boda-akos/STM32_Voltmeter_Data-Logger_Curve-Tracer_Continuity-Tester/DSCF2569 (Nagy).JPG

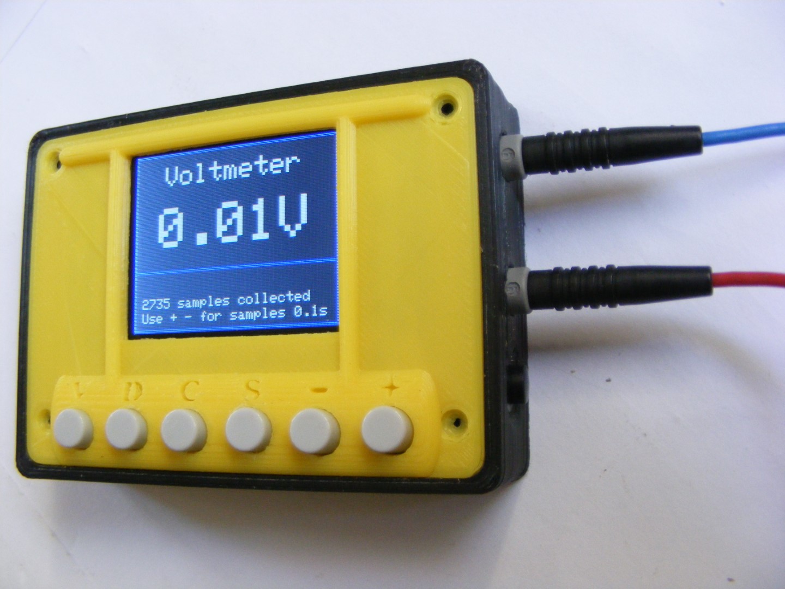
DSCF2569 (Nagy).JPG
