boda-akos/STM32_Voltmeter_Data-Logger_Curve-Tracer_Continuity-Tester/DSCF2566 (Nagy).JPG

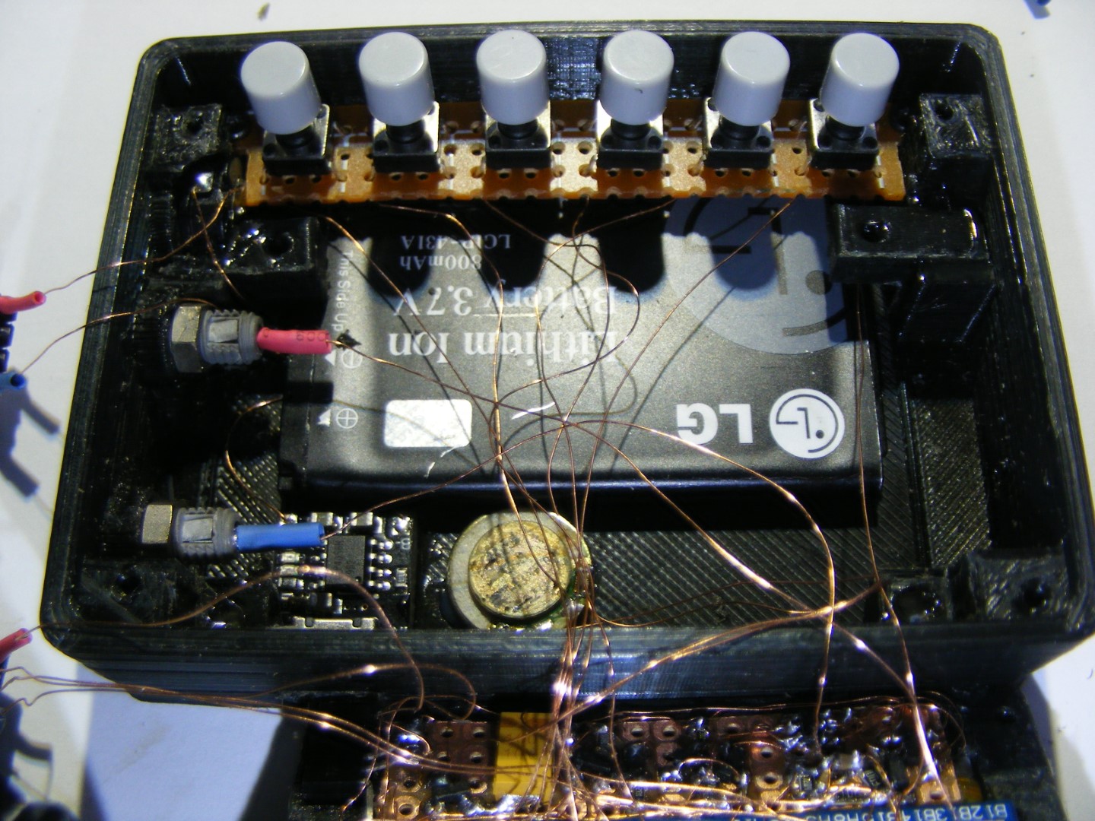
DSCF2566 (Nagy).JPG
