boda-akos/STM32_Voltmeter_Data-Logger_Curve-Tracer_Continuity-Tester/DSCF2555 (Nagy).JPG

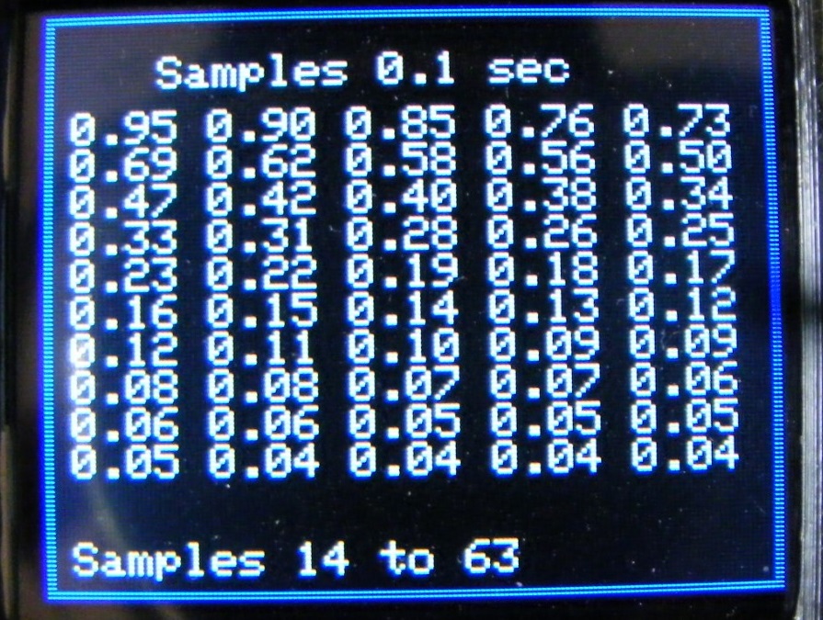
DSCF2555 (Nagy).JPG
