boda-akos/STM32_Voltmeter_Data-Logger_Curve-Tracer_Continuity-Tester/DSCF2561 (Nagy).JPG

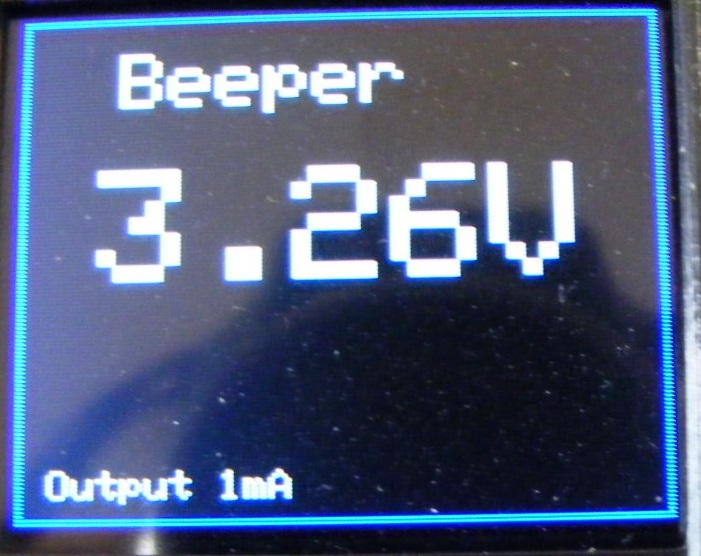
DSCF2561 (Nagy).JPG
