boda-akos/STM32_Voltmeter_Data-Logger_Curve-Tracer_Continuity-Tester/DSCF2562 (Nagy).JPG

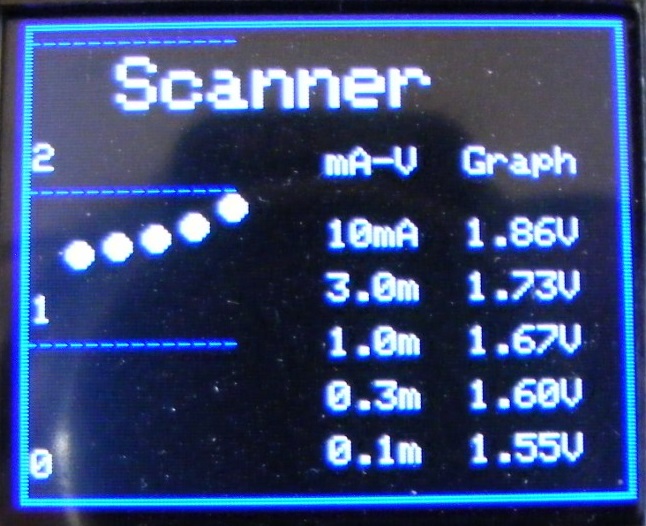
DSCF2562 (Nagy).JPG
