boda-akos/STM32_Voltmeter_Data-Logger_Curve-Tracer_Continuity-Tester/DSCF2565 (Nagy).JPG

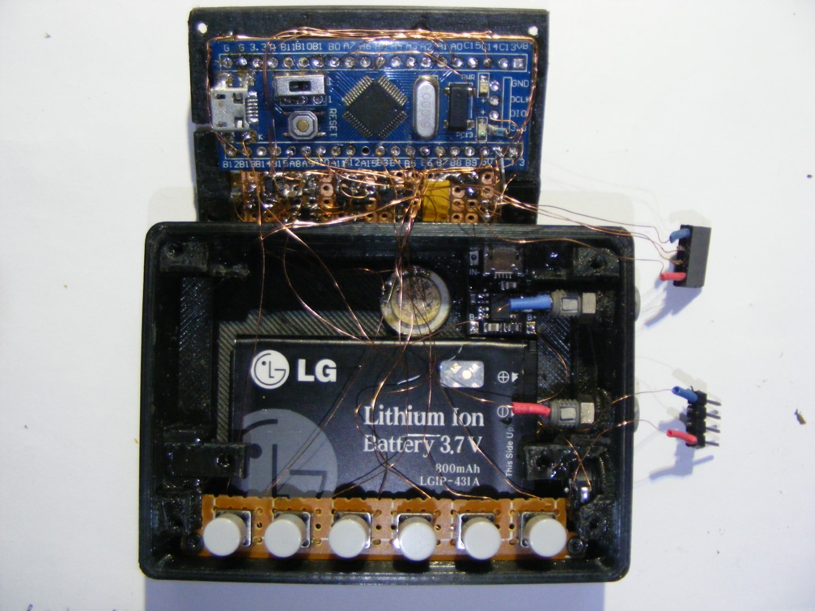
DSCF2565 (Nagy).JPG
