boda-akos/STM32_Voltmeter_Data-Logger_Curve-Tracer_Continuity-Tester/DSCF2567 (Nagy).JPG

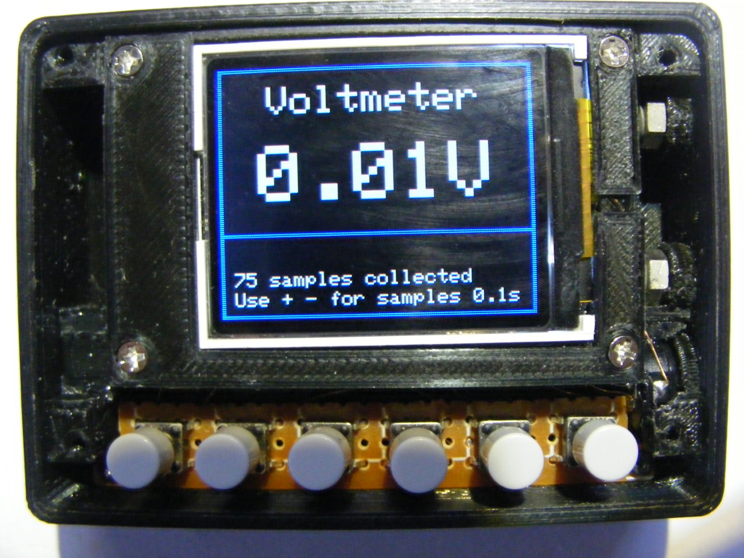
DSCF2567 (Nagy).JPG
