boda-akos/STM32_Voltmeter_Data-Logger_Curve-Tracer_Continuity-Tester/DSCF2568 (Nagy).JPG

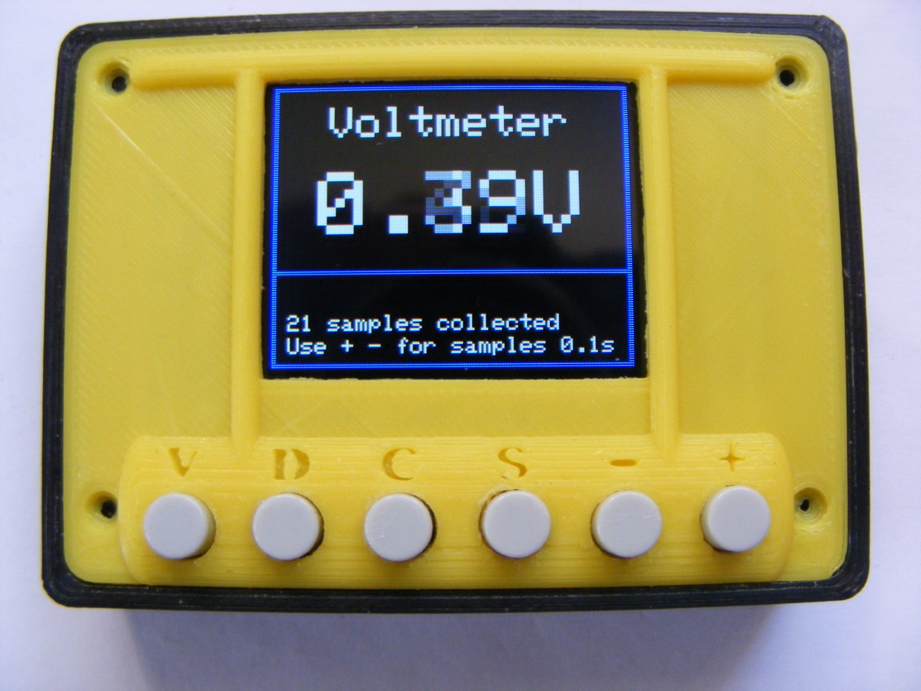
DSCF2568 (Nagy).JPG
