boda-akos/STM32_Voltmeter_Data-Logger_Curve-Tracer_Continuity-Tester/DSCF2570 (Nagy).JPG

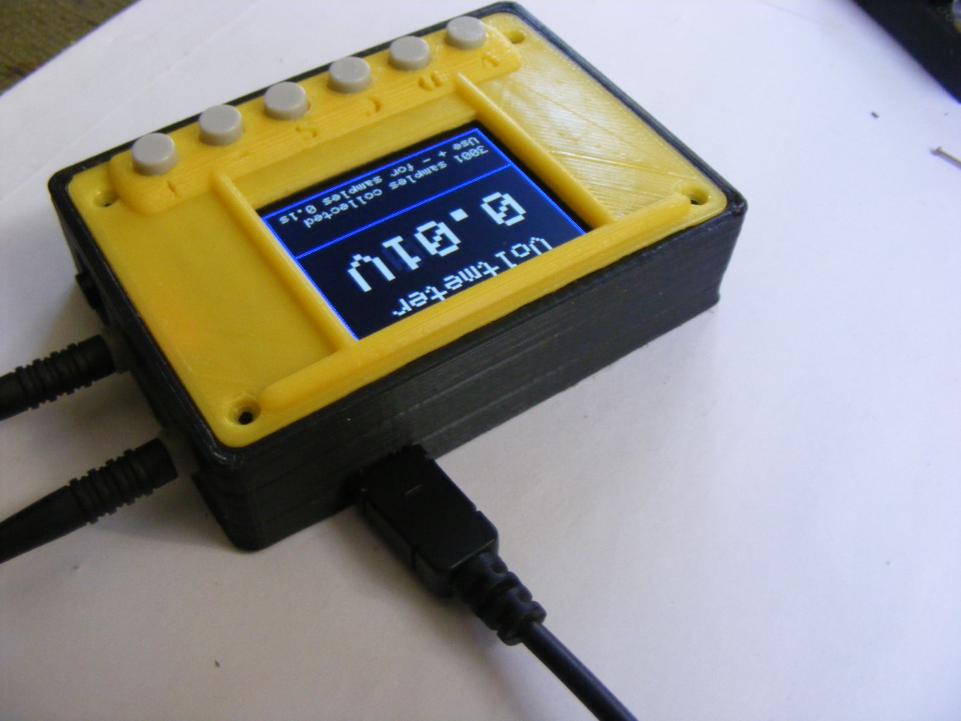
DSCF2570 (Nagy).JPG
