boda-akos/STM32_Voltmeter_Data-Logger_Curve-Tracer_Continuity-Tester/DvmBlack.stl

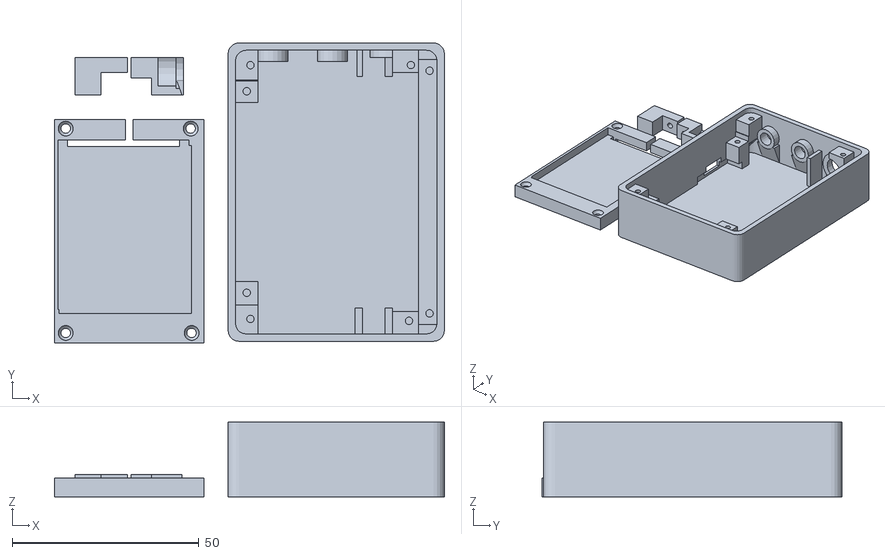
[picture p10: CAD file, 2020-10-23]
DvmBlack.stl
104.5 x 80.5 x 20.0
