boda-akos/STM32_Voltmeter_Data-Logger_Curve-Tracer_Continuity-Tester/DvmYellow.stl

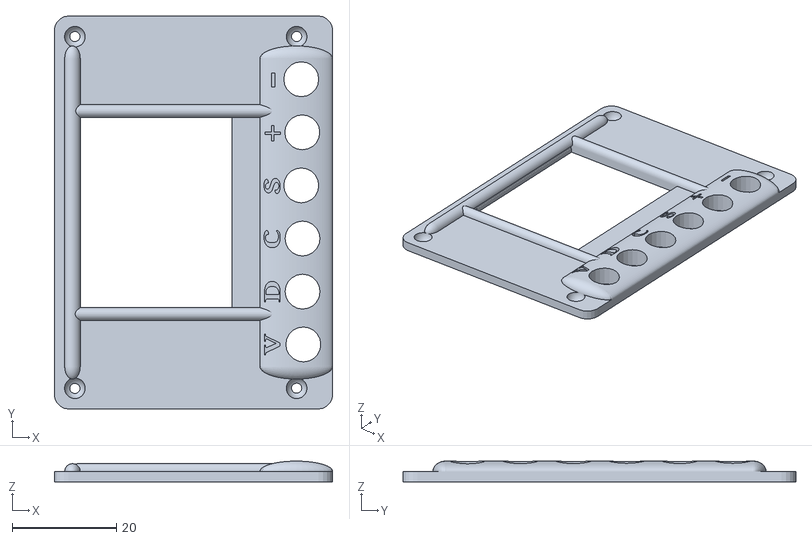
[picture p11: CAD file, 2020-10-23]
DvmYellow.stl
53.5 x 75.5 x 4.00
