boda-akos/STM32_Voltmeter_Data-Logger_Curve-Tracer_Continuity-Tester/Schematic_dvmSTM32_2020-10-22_17-42-16.pdf

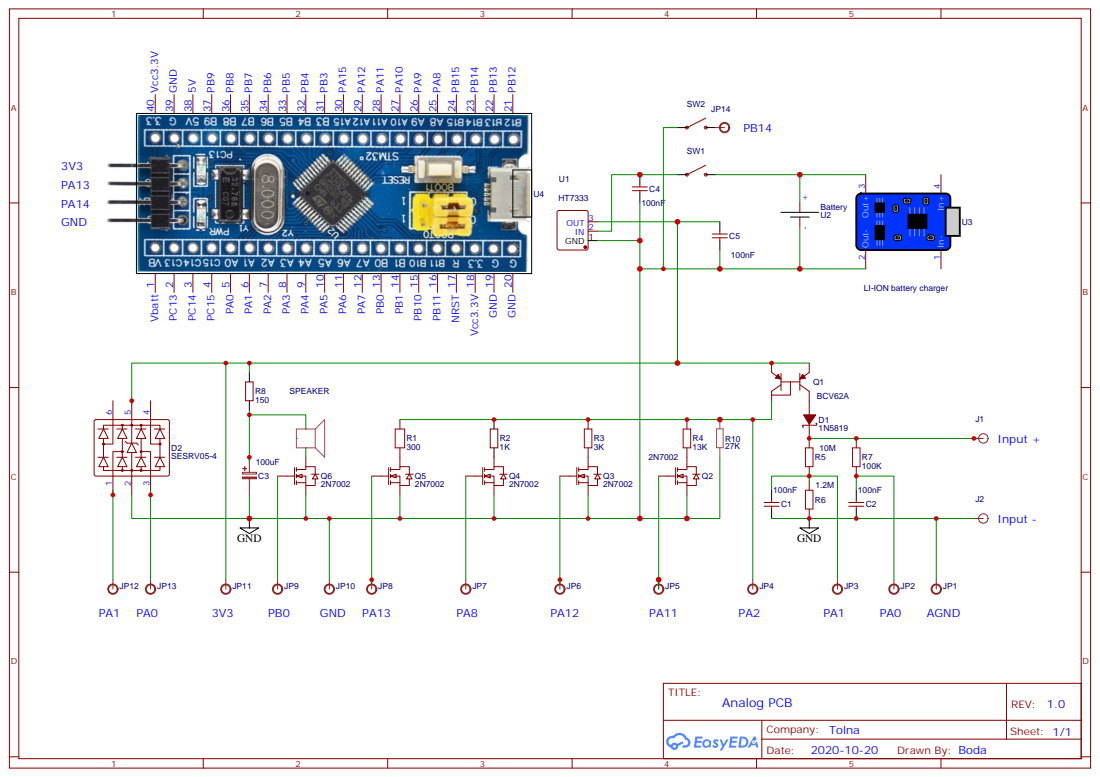
[picture p12: page 1]

LI-ION battery charger

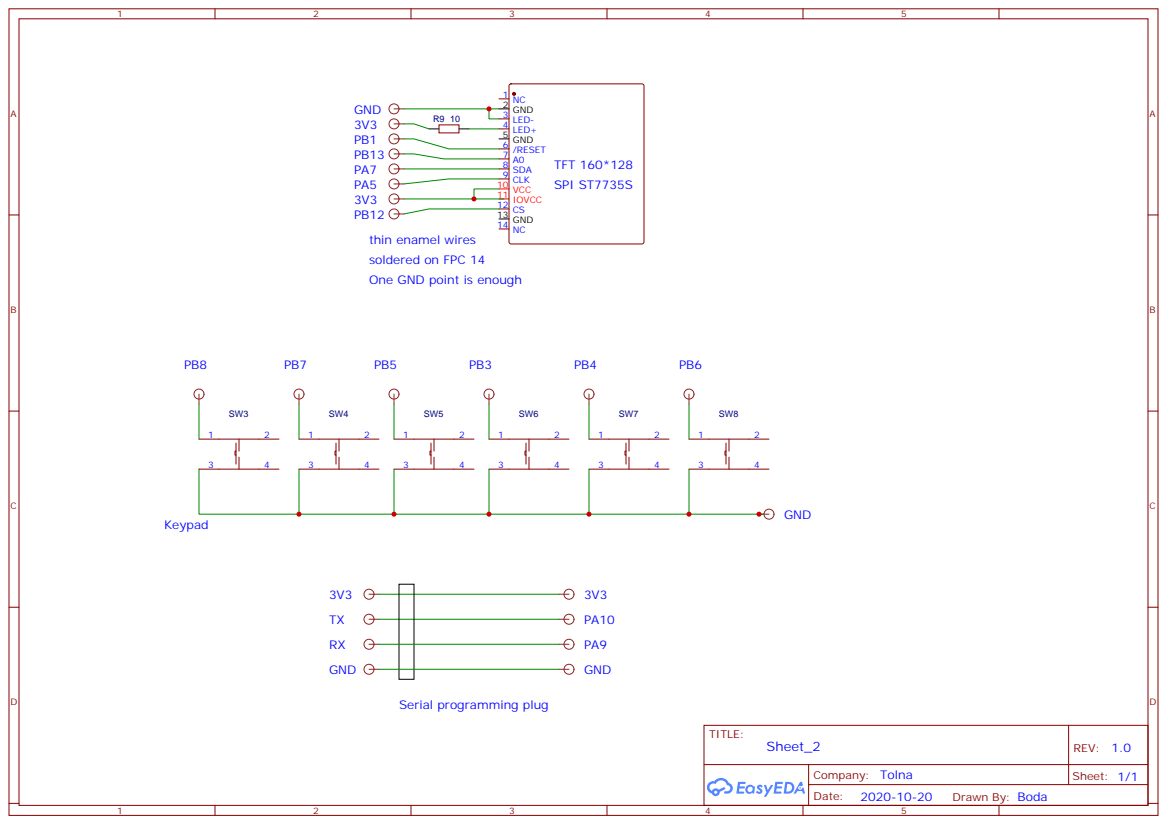
[picture p13: page 2]
